GrummHD/CO2-Sensor/README.md

# CO2-Sensor
Software für einen CO2 Sensor mit ESP8266 und Thingspeak-Zugang
