GrummHD/CO2-Sensor/secrets.h

// Use this file to store all of the private credentials 
// and connection details

#define SECRET_SSID "--"    // replace MySSID with your WiFi network name
#define SECRET_PASS "--"  // replace MyPassword with your WiFi password
#define SECRET_CH_ID --			// replace 0000000 with your channel number
#define SECRET_WRITE_APIKEY "--"   // replace XYZ with your channel write API Key
